ozw1z5rd/RAM2E/Documentation/BackIsom.png

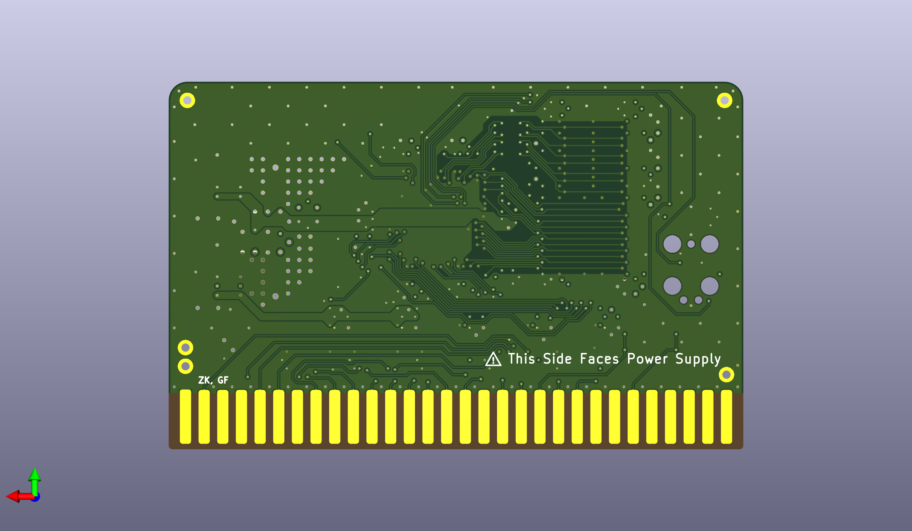
Documentation/BackIsom.png
