ozw1z5rd/RAM2E/Documentation/FrontIsom.png

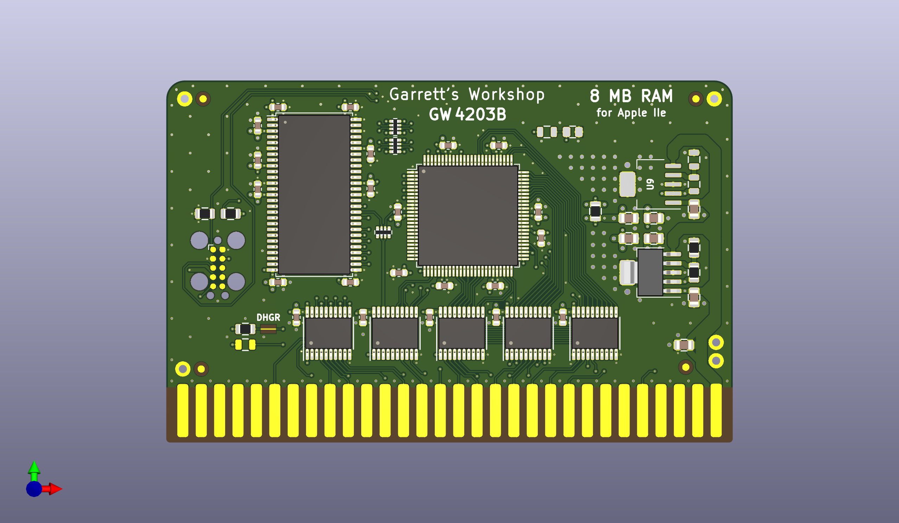
Documentation/FrontIsom.png
