ozw1z5rd/RAM2E/RAM2E.kicad_pcb

## KiCad design RAM2E.kicad_pcb (2020-03-21)

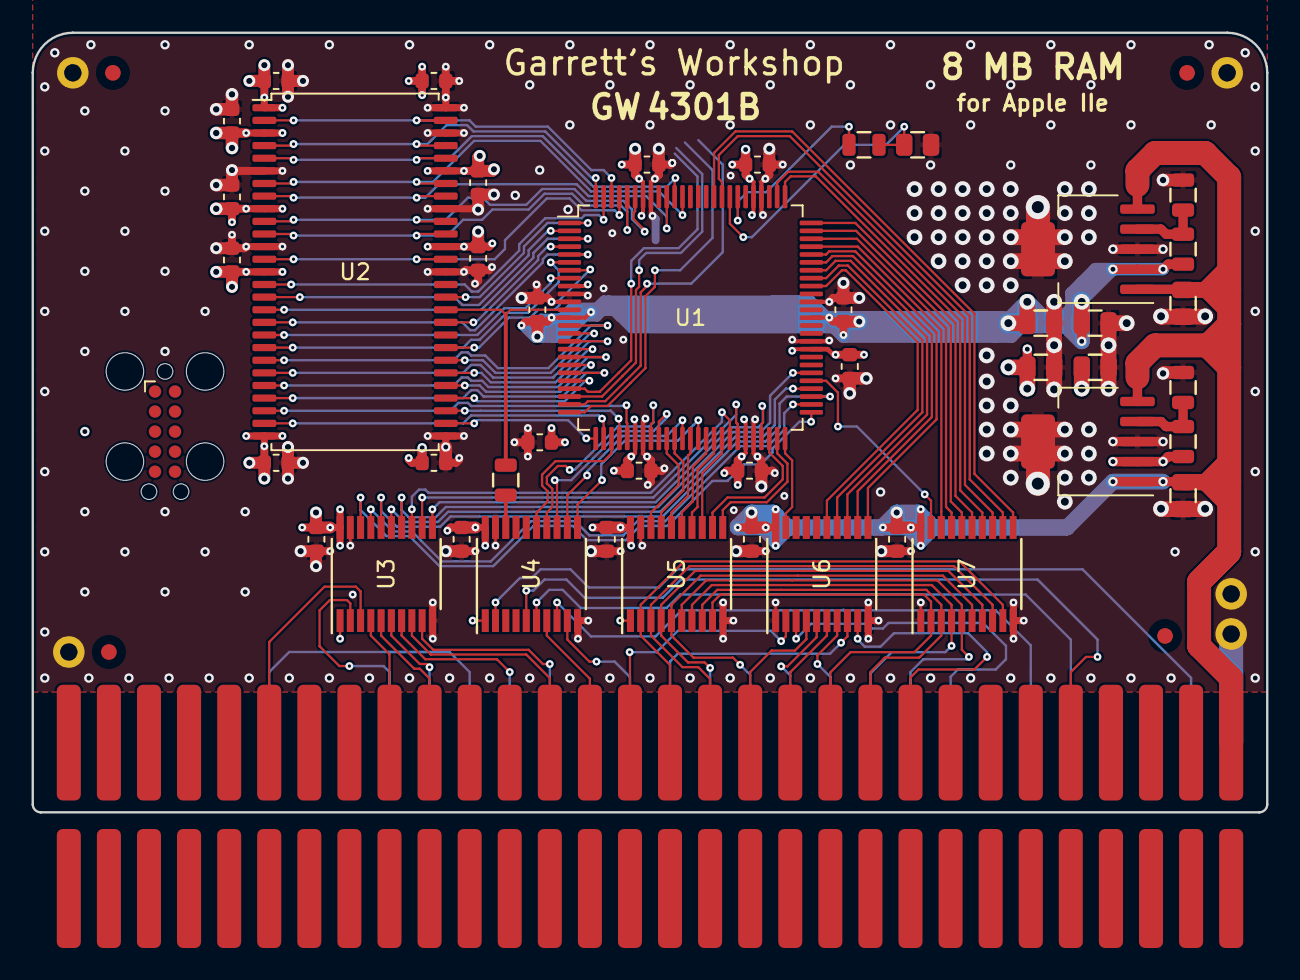
[picture p3: board RAM2E.kicad_pcb from above]

Board: 4 copper layers, 78.2 x 49.4 mm, 19 parts (0 on the bottom side), 3 nets.

Parts:
FID1, FID2, FID3, FID4: Fiducial
H1, H2, H4, H4#2, H4#3: PasteHole_1.1mm_PTH
J1: AppleIIeAux; AppleIIeAux_Edge
U1: TQFP-100_14x14mm_P0.5mm
U2: TSOP-II-54_22.2x10.16mm_P0.8mm
U3, U4, U5, U6, U7: TSSOP-20_4.4x6.5mm_P0.65mm
U8, U9: SOT-223-6

Connections:
+5V: J1.30, U6.20, U7.20, U8.1, U8.5, U9.1, U9.5
/AN3: J1.50, J1.55
GND: H1.1, H2.1, H4.1, H4#2.1, H4#3.1, J1.31, U1.10, U1.11, U1.32, U1.46, U1.60, U1.65, U1.79, U1.93, U2.6, U2.12, U2.28, U2.41, U2.46, U2.52, U2.54, U3.10, U3.19, U4.10, U4.19, U5.10, U5.19, U6.1, U6.10, U7.1, U7.10, U8.3, U8.6, U9.3, U9.6
