ozw1z5rd/RAM2E/(commit log)

2019-06-09 Done some
    [ramiie.kicad_pcb, ramiie.sch]
2019-06-10 did a lot
    [ramiie.kicad_pcb, ramiie.sch]
2019-06-25 I think it's done
    [ramiie.kicad_pcb, ramiie.sch]
2019-06-26 Changed name to "RAM2E"
    [RAM2E.kicad_pcb, RAM2E.sch]
2019-07-30 halfway done widening clearances
    [RAM2E-B_Cu.gbl, RAM2E-B_Mask.gbs, RAM2E-B_SilkS.gbo, RAM2E-Edge_Cuts.gm1, RAM2E-F_Cu.gtl, RAM2E-F_Mask.gts, RAM2E-F_Paste.gtp, RAM2E-F_SilkS.gto]
2019-07-30 Finished new revision 0.6
    Wider clearance and 1 more bypass cap
    [RAM2E-B_Cu.gbl, RAM2E-B_Mask.gbs, RAM2E-B_SilkS.gbo, RAM2E-Edge_Cuts.gm1, RAM2E-F_Cu.gtl, RAM2E-F_Mask.gts, RAM2E-F_Paste.gtp, RAM2E-F_SilkS.gto]
2019-08-01 New CPLD idea
    Also changed to 1k2R + 10pF RC delay
    [RAM2E.sch]
2019-10-14 CPLD design prototype
2019-10-14 Schematic documentation update
    [Docs.sch, RAM2E.kicad_pcb, RAM2E.sch]
2019-10-18 PLD: Delay EN80 like on Apple extended 80-column board
    [Docs.sch]
2019-11-18 Start redoing state...
    [Docs.sch]
2019-11-18 Changed to state counter
    [Docs.sch, RAM2E.sch]
2019-12-08 Release candidate
    [_saved_RAM2E.sch]
2020-02-17 Timing fixes
    [Docs.sch, RAM2E.sch]
2020-04-27 Sent to JLCPCB
    [Docs.sch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]
2020-04-27 Fixed board GW number silkscreen, added config jumpers
    [RAM2E.sch]
2020-05-06 Added jumper, new state machine docs
    [Docs.sch, RAM2E.sch]
2020-05-06 Tuned timing assignment stuff
    [Docs.sch, RAM2E.sch]
2020-05-18 As sent to JLCPCB May 2020
    [RAM2E 2.drl, RAM2E-B_Cu 2.gbl, RAM2E-B_Cu.gbl, RAM2E-B_Mask 2.gbs, RAM2E-B_Mask.gbs, RAM2E-B_SilkS 2.gbo, RAM2E-B_SilkS.gbo, RAM2E-Edge_Cuts 2.gm1]
2020-05-22 Added capacity selection
    [Docs.sch, RAM2E.sch]
2020-07-25 Documentation update
    [Docs.sch, RAM2E.sch]
